anatol333/Vibration-Sensor/README.md

# Vibration-Sensor
## Data relevant to the vibration sensor prototype sent to USA.
Content:
- flushDetector_7_multilevel: Arduino code programmed into controller.
- vibrationSensorPrototype_wiring.jpg: wiring of hardware.
- prototype_Description_1.pdf: description of functioning.
- Development-data: results of testing with different sounds and sensors.
