anatol333/Vibration-Sensor/Flush-Infrared_sensor/READMe.md

Last version of software.

The relevant schematics, state on 04.11.2025:
schematics_1
