anatol333/Vibration-Sensor/Development-data/sensorOptimization.docx

1 coin:

Tap:

1000/60=17

3 coins:


200...250 Hz

Parallel: 5-7+9-30-2 1st second: 3.6 ... 8.6 ms 2nd second: 3.1 ... 4.8ms

5-7+9-46-32 1st second: 3.3 ... 5.5 ms; 2nd second: 3.0 ... 4.0ms

perpendicular: 5-7+8-25-32 1st second: 2.8 ... 7.2 ms

============================================================================

tap:

1500/90=17 250...330 Hz

Water jet from hight 80 cm from flor:

in water:

180 mV (/8) 250...330 Hz

in porcelan: ~30 mV.

Bar, tank in the wall:

PROTOTYPE

3.0 V; threshold signal for 1800/1000 ms, maxPauseDuration = 100, threshold=2380:
