anatol333/Vibration-Sensor/vibrationSensorPrototype_wiring.jpg

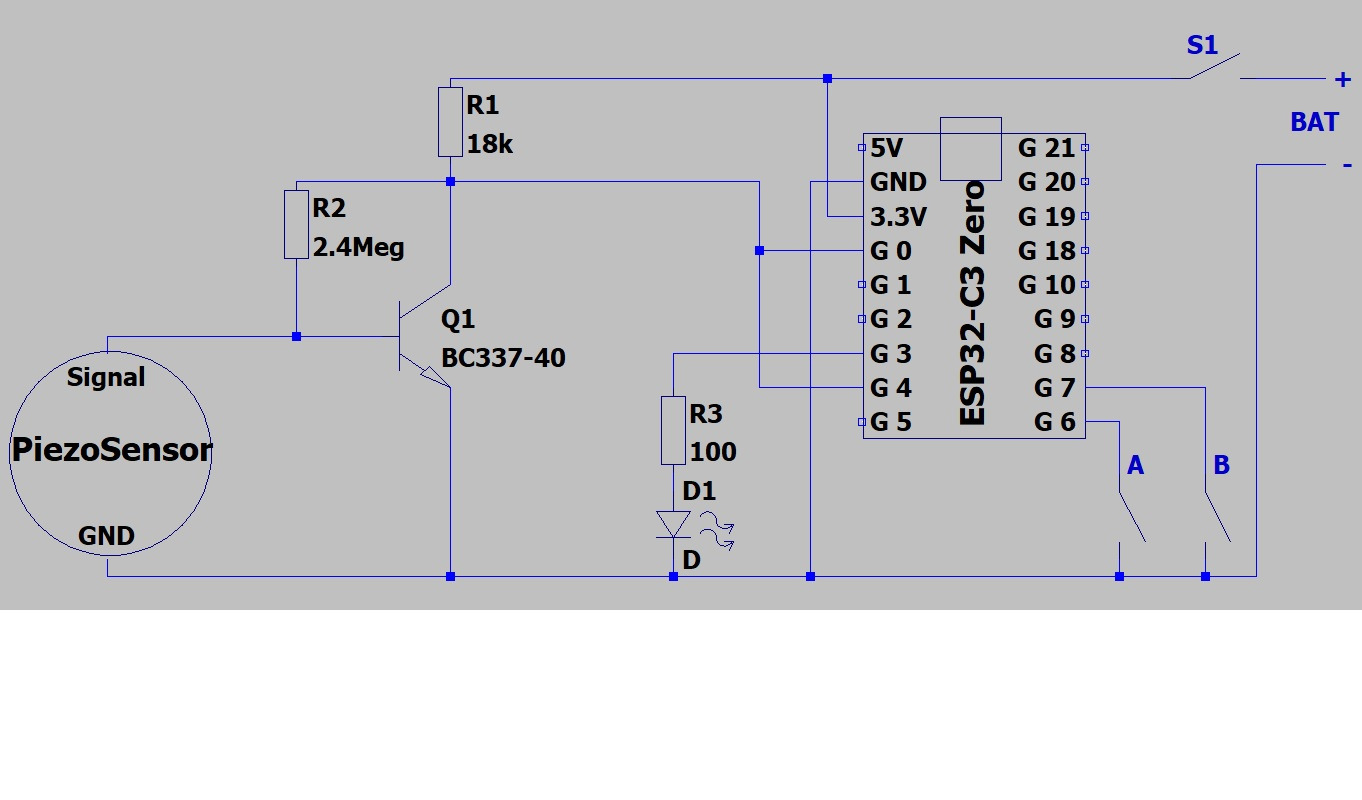
vibrationSensorPrototype_wiring.jpg
